Funny59/jubilant-couscous/motherboard.kicad_pcb

## KiCad design motherboard.kicad_pcb (2022-05-28)

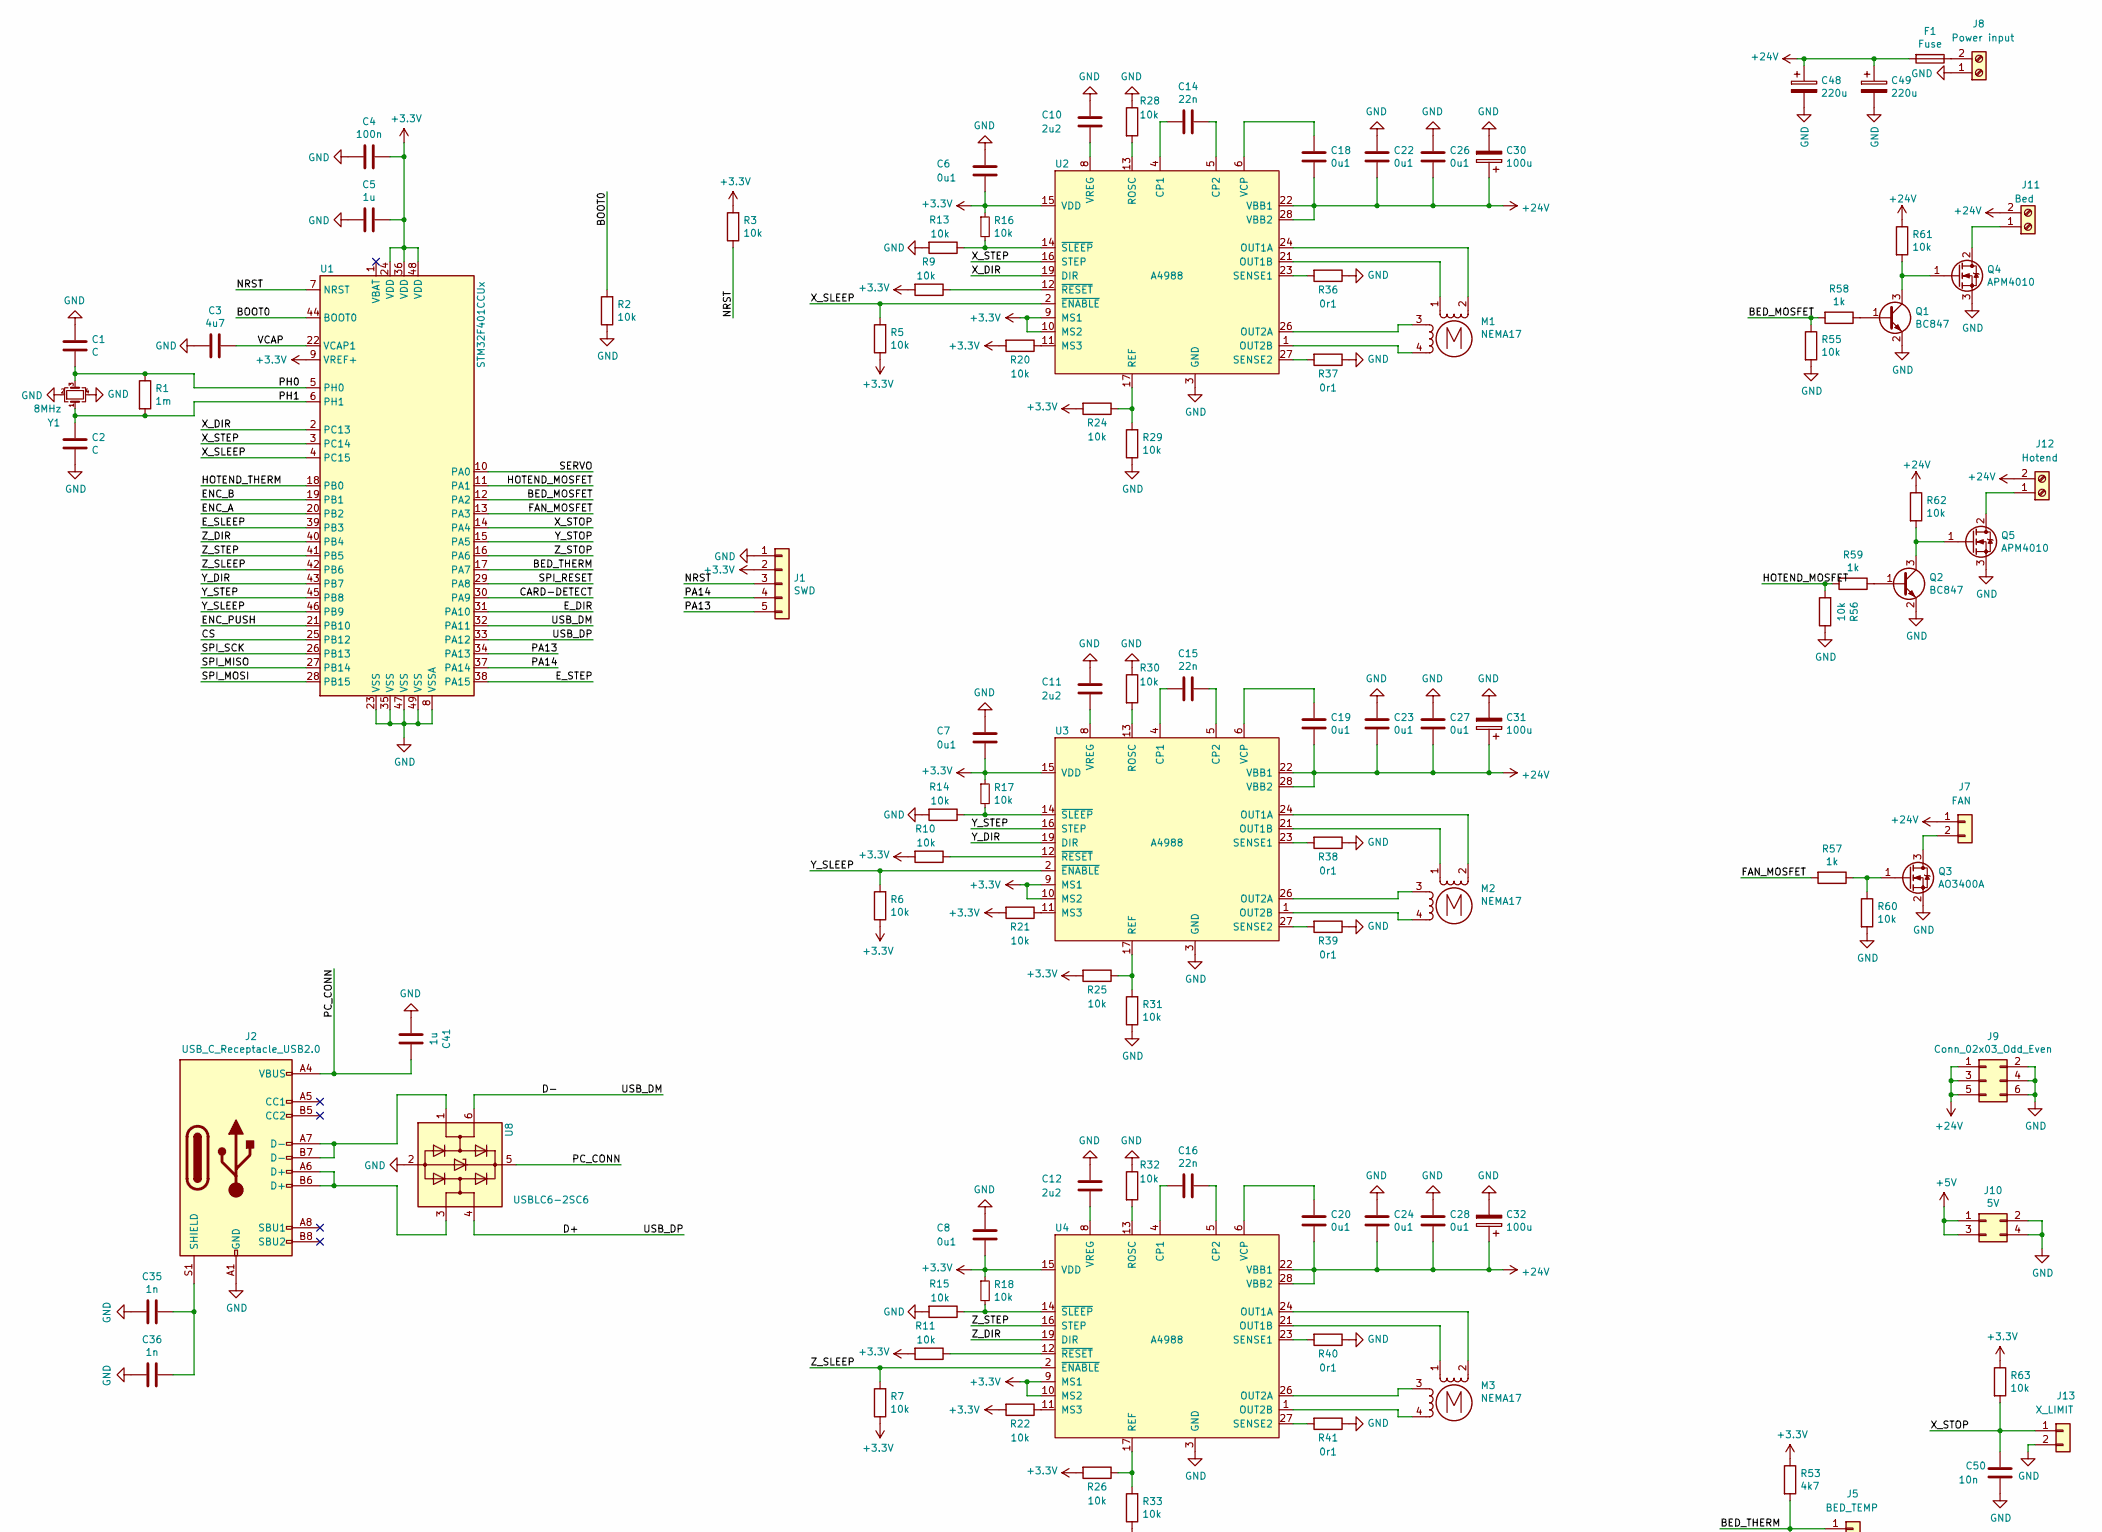
[picture p1: schematic motherboard.sch, part in row 1, column 1]

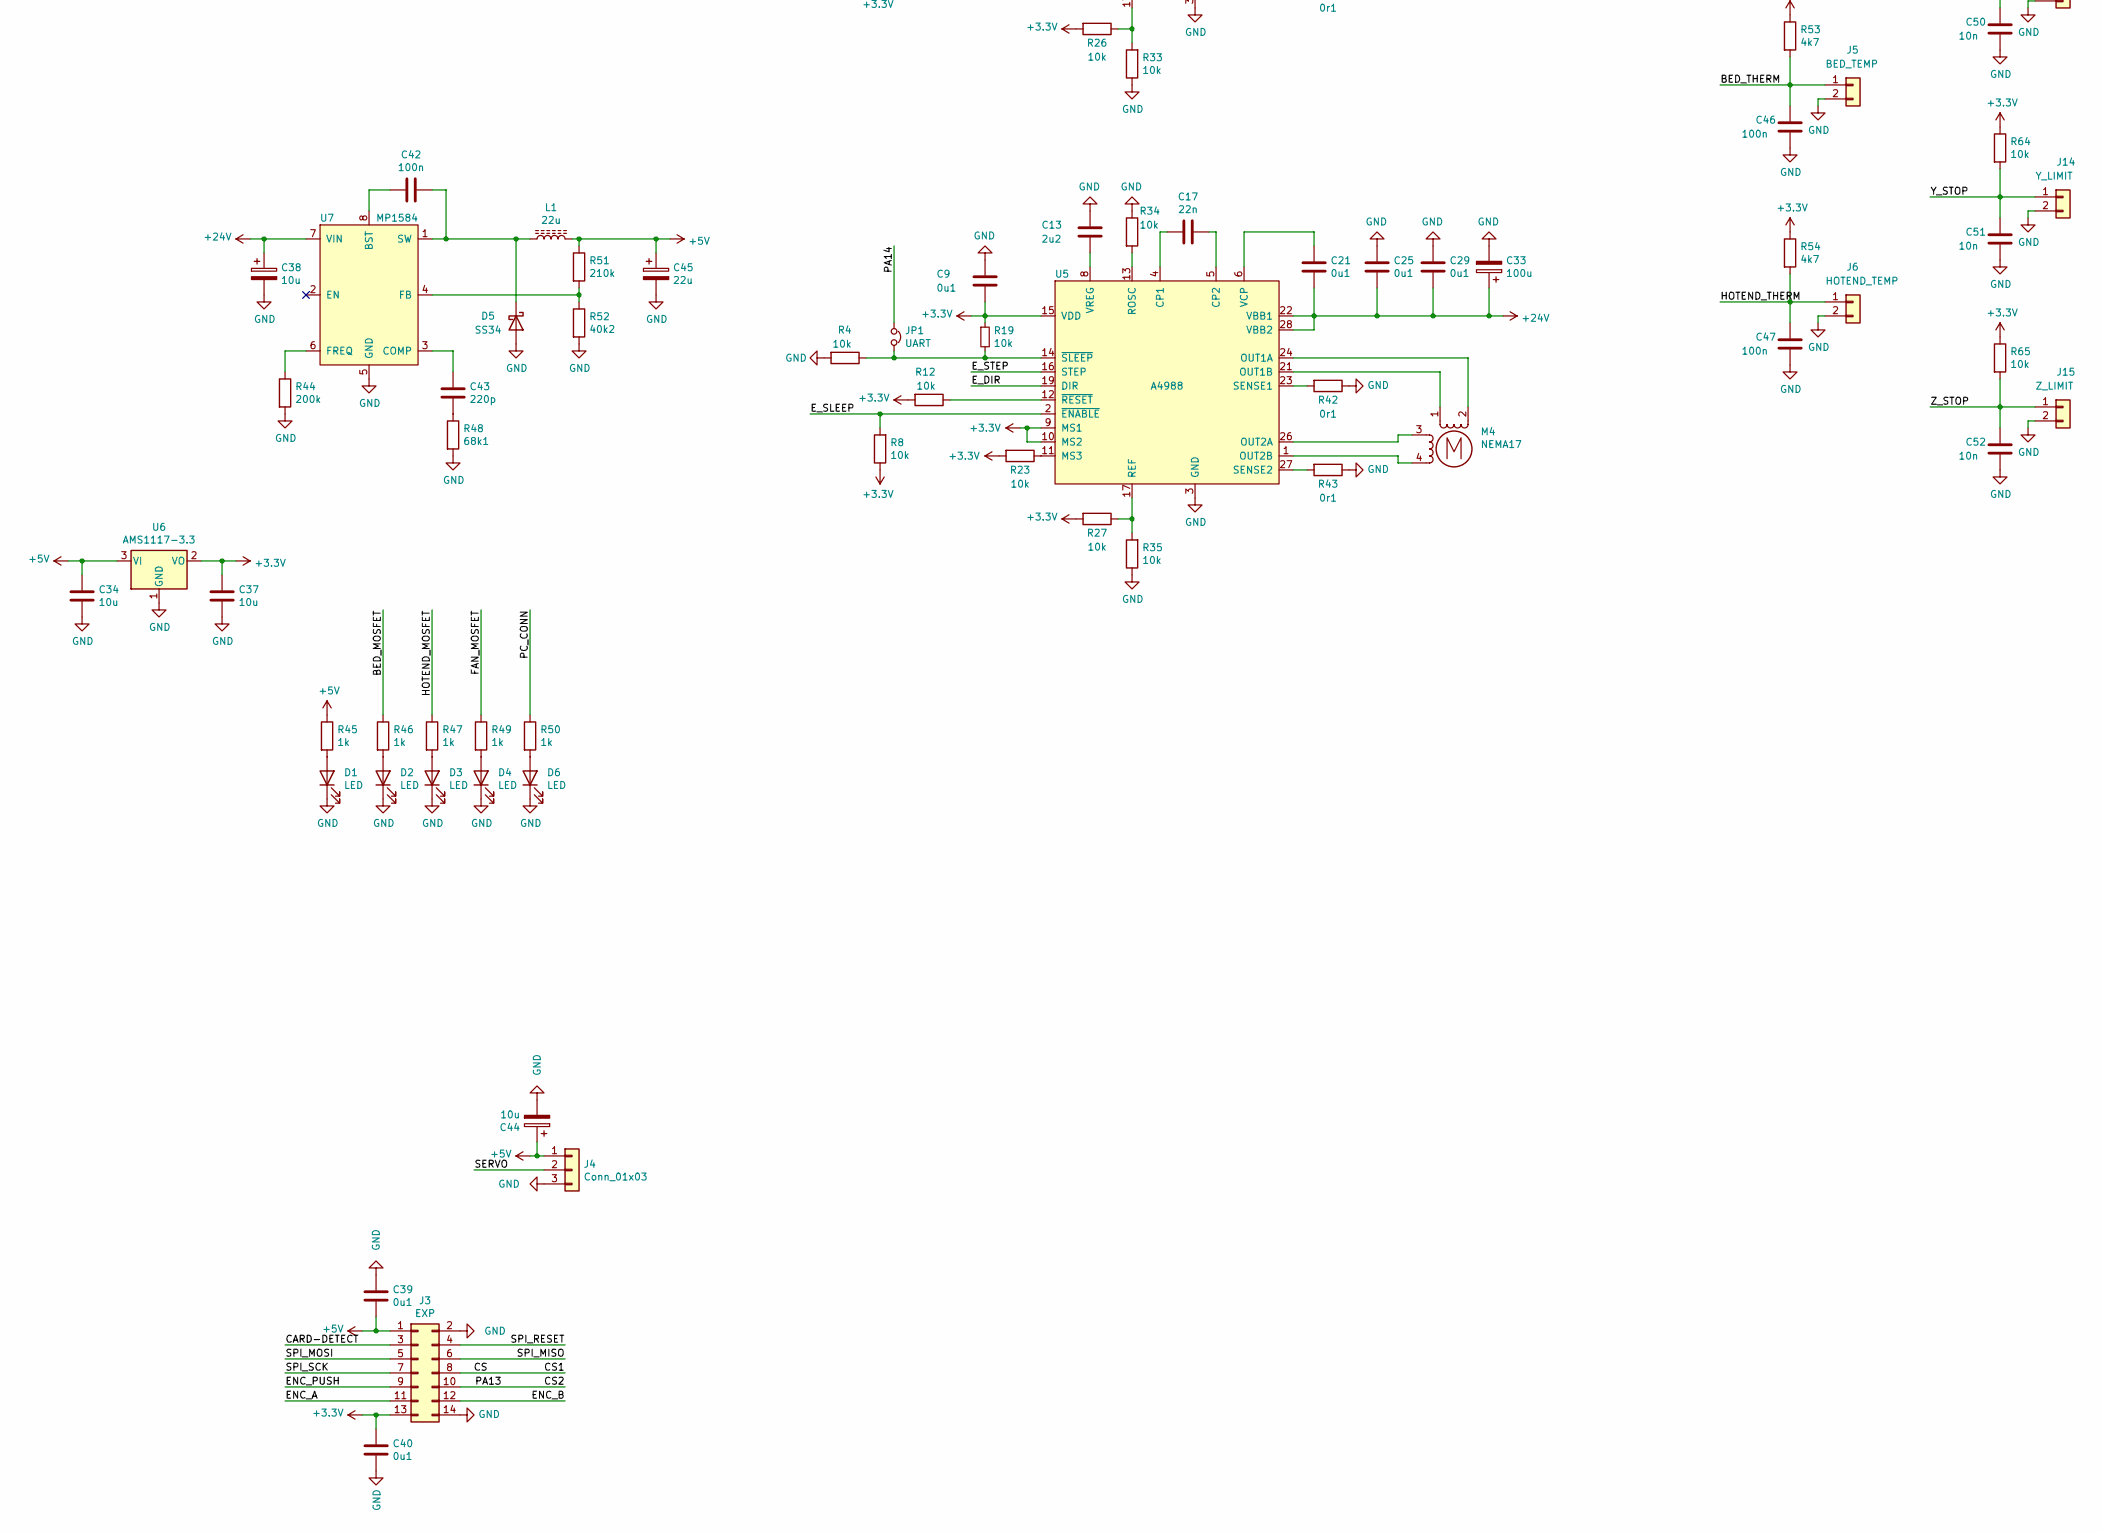
[picture p2: schematic motherboard.sch, part in row 2, column 1]

Parts:
C1, C2: C; C_0603_1608Metric_Pad1.08x0.95mm_HandSolder
C3: 4u7; C_0603_1608Metric_Pad1.08x0.95mm_HandSolder
C4, C42, C46, C47: 100n; C_0603_1608Metric_Pad1.08x0.95mm_HandSolder
C5, C41: 1u; C_0603_1608Metric_Pad1.08x0.95mm_HandSolder
C6, C7, C8, C9, C18, C19, C20, C21, C22, C23, C24, C25, C26, C27, C28, C29, C39, C40: 0u1; C_0603_1608Metric_Pad1.08x0.95mm_HandSolder
C10, C11, C12, C13: 2u2; C_0603_1608Metric_Pad1.08x0.95mm_HandSolder
C14, C15, C16, C17: 22n; C_0603_1608Metric_Pad1.08x0.95mm_HandSolder
C30, C31, C32, C33: 100u; CP_Radial_D8.0mm_P3.50mm
C34, C37: 10u; C_0805_2012Metric_Pad1.18x1.45mm_HandSolder
C35, C36: 1n; C_0603_1608Metric_Pad1.08x0.95mm_HandSolder
C38, C44: 10u; CP_EIA-3528-21_Kemet-B_Pad1.50x2.35mm_HandSolder
C43: 220p; C_0603_1608Metric_Pad1.08x0.95mm_HandSolder
C45: 22u; CP_EIA-3528-21_Kemet-B_Pad1.50x2.35mm_HandSolder
C48, C49: 220u; CP_Radial_D8.0mm_P3.50mm
C50, C51, C52: 10n; C_0603_1608Metric_Pad1.08x0.95mm_HandSolder
D1, D2, D3, D4, D6: LED; LED_0603_1608Metric_Pad1.05x0.95mm_HandSolder
D5: SS34; D_SMA-SMB_Universal_Handsoldering
F1: Fuse; Fuse_Blade_Mini_directSolder
J1: SWD; PinHeader_1x05_P2.54mm_Vertical
J2: USB_C_Receptacle_USB2.0; USB_C_Receptacle_Palconn_UTC16-G
J3: EXP; IDC-Header_2x07_P2.54mm_Vertical
J4: Conn_01x03; JST_XH_B3B-XH-A_1x03_P2.50mm_Vertical
J5: BED_TEMP; JST_XH_B2B-XH-A_1x02_P2.50mm_Vertical
J6: HOTEND_TEMP; JST_XH_B2B-XH-A_1x02_P2.50mm_Vertical
J7: FAN; JST_XH_B2B-XH-A_1x02_P2.50mm_Vertical
J8: Power input; TerminalBlock_bornier-2_P5.08mm
J9: Conn_02x03_Odd_Even; PinHeader_2x03_P2.54mm_Vertical
J10: 5V; PinHeader_2x02_P2.54mm_Vertical
J11: Bed; TerminalBlock_bornier-2_P5.08mm
J12: Hotend; TerminalBlock_bornier-2_P5.08mm
J13: X_LIMIT; JST_XH_B2B-XH-A_1x02_P2.50mm_Vertical
J14: Y_LIMIT; JST_XH_B2B-XH-A_1x02_P2.50mm_Vertical
J15: Z_LIMIT; JST_XH_B2B-XH-A_1x02_P2.50mm_Vertical
JP1: UART; SolderJumper-2_P1.3mm_Open_TrianglePad1.0x1.5mm
L1: 22u; SDR0604
M1, M2, M3, M4: NEMA17; JST_XH_B4B-XH-A_1x04_P2.50mm_Vertical
Q1, Q2: BC847; SOT-23
Q3: AO3400A; SOT-23
Q4, Q5: APM4010; TO-252-2
R1: 1m; R_0603_1608Metric_Pad0.98x0.95mm_HandSolder
R2, R3, R24, R25, R26, R27, R55, R56, R60, R61, R62, R63, R64, R65: 10k; R_0603_1608Metric_Pad0.98x0.95mm_HandSolder
R4, R5, R6, R7, R8, R9, R10, R11, R12, R13, R14, R15, R16, R17, R18, R19, R20, R21, R22, R23, R28, R30, R32, R34: 10k; R_0402_1005Metric_Pad0.72x0.64mm_HandSolder
R29, R31, R33, R35: 10k; Potentiometer_Bourns_TC33X_Vertical
R36, R37, R38, R39, R40, R41, R42, R43: 0r1; R_1206_3216Metric_Pad1.30x1.75mm_HandSolder
R44: 200k; R_0603_1608Metric_Pad0.98x0.95mm_HandSolder
R45, R46, R47, R49, R50, R57, R58, R59: 1k; R_0603_1608Metric_Pad0.98x0.95mm_HandSolder
R48: 68k1; R_0603_1608Metric_Pad0.98x0.95mm_HandSolder
R51: 210k; R_0603_1608Metric_Pad0.98x0.95mm_HandSolder
R52: 40k2; R_0603_1608Metric_Pad0.98x0.95mm_HandSolder
R53, R54: 4k7; R_0603_1608Metric_Pad0.98x0.95mm_HandSolder
U1: STM32F401CCUx; QFN-48-1EP_7x7mm_P0.5mm_EP5.6x5.6mm
U2, U3, U4, U5: A4988; QFN-28-1EP_5x5mm_P0.5mm_EP3.35x3.35mm_ThermalVias
U6: AMS1117-3.3; SOT-223-3_TabPin2
U7: MP1584; SOIC-8-1EP_3.9x4.9mm_P1.27mm_EP2.29x3mm_ThermalVias
U8: USBLC6-2SC6; SOT-23-6
Y1: 8MHz; Crystal_SMD_3225-4Pin_3.2x2.5mm

Connections:
+3V3: C4.1, C5.1, C6.2, C7.2, C8.2, C9.2, C37.1, C40.2, J1.2, J3.13, R3.2, R5.1, R6.1, R7.1, R8.1, R9.2, R10.2, R11.2, R12.2, R16.1, R17.1, R18.1, R19.1, R20.2, R21.2, R22.2, R23.2, R24.2, R25.2, R26.2, R27.2, R53.1, R54.1, R63.1, R64.1, R65.1, U1.9 (VREF+), U1.24 (VDD), U1.36 (VDD), U1.48 (VDD), U2.9 (MS1), U2.10 (MS2), U2.15 (VDD), U3.9 (MS1), U3.10 (MS2), U3.15 (VDD), U4.9 (MS1), U4.10 (MS2), U4.15 (VDD), U5.9 (MS1), U5.10 (MS2), U5.15 (VDD), U6.2 (VO)
+5V: C34.1, C39.1, C44.1, C45.1, J3.1, J4.1, J10.1, J10.3, L1.2, R45.1, R51.1, U6.3 (VI)
+24V: C18.1, C19.1, C20.1, C21.1, C22.1, C23.1, C24.1, C25.1, C26.1, C27.1, C28.1, C29.1, C30.1, C31.1, C32.1, C33.1, C38.1, C48.1, C49.1, F1.2, J7.1, J9.1, J9.3, J9.5, J11.2, J12.2, R61.1, R62.1, U2.22 (VBB1), U2.28 (VBB2), U3.22 (VBB1), U3.28 (VBB2), U4.22 (VBB1), U4.28 (VBB2), U5.22 (VBB1), U5.28 (VBB2), U7.7 (VIN); also elsewhere on the board
/BED_MOSFET: R46.1, R55.1, R58.2, U1.12 (PA2)
/BED_THERM: C46.1, J5.1, R53.2, U1.17 (PA7)
/BOOT0: R2.2, U1.44 (BOOT0)
/CARD-DETECT: J3.3, U1.30 (PA9)
/CS: J3.8, U1.25 (PB12)
/CS2: J1.5, J3.10, U1.34 (PA13)
/D+: U1.33 (PA12), U8.4 (I/O2)
/D-: U1.32 (PA11), U8.6 (I/O1)
/ENC_A: J3.11, U1.20 (PB2)
/ENC_B: J3.12, U1.19 (PB1)
/ENC_PUSH: J3.9, U1.21 (PB10)
/E_DIR: U1.31 (PA10), U5.19 (DIR)
/E_SLEEP: R8.2, U1.39 (PB3), U5.2 (~ENABLE)
/E_STEP: U1.38 (PA15), U5.16 (STEP)
/FAN_MOSFET: R49.1, R57.2, U1.13 (PA3)
/HOTEND_MOSFET: R47.1, R56.2, R59.2, U1.11 (PA1)
/HOTEND_THERM: C47.1, J6.1, R54.2, U1.18 (PB0)
/NRST: J1.3, R3.1, U1.7 (NRST)
/PA14: J1.4, JP1.1, U1.37 (PA14)
/PC_CONN: C41.1, J2.A4 (VBUS), J2.A9 (VBUS), J2.B4 (VBUS), J2.B9 (VBUS), R50.1, U8.5 (VBUS)
/PH0: C1.2, R1.1, U1.5 (PH0), Y1.3
/PH1: C2.1, R1.2, U1.6 (PH1), Y1.1
/SERVO: J4.2, U1.10 (PA0)
/SPI_MISO: J3.6, U1.27 (PB14)
/SPI_MOSI: J3.5, U1.28 (PB15)
/SPI_RESET: J3.4, U1.29 (PA8)
/SPI_SCK: J3.7, U1.26 (PB13)
/VCAP: C3.1, U1.22 (VCAP1)
/X_DIR: U1.2 (PC13), U2.19 (DIR)
/X_SLEEP: R5.2, U1.4 (PC15), U2.2 (~ENABLE)
/X_STEP: U1.3 (PC14), U2.16 (STEP)
/X_STOP: C50.1, J13.1, R63.2, U1.14 (PA4)
/Y_DIR: U1.43 (PB7), U3.19 (DIR)
/Y_SLEEP: R6.2, U1.46 (PB9), U3.2 (~ENABLE)
/Y_STEP: U1.45 (PB8), U3.16 (STEP)
/Y_STOP: C51.1, J14.1, R64.2, U1.15 (PA5)
/Z_DIR: U1.40 (PB4), U4.19 (DIR)
/Z_SLEEP: R7.2, U1.42 (PB6), U4.2 (~ENABLE)
/Z_STEP: U1.41 (PB5), U4.16 (STEP)
/Z_STOP: C52.1, J15.1, R65.2, U1.16 (PA6)
GND: C1.1, C2.2, C3.2, C4.2, C5.2, C6.1, C7.1, C8.1, C9.1, C10.1, C11.1, C12.1, C13.1, C22.2, C23.2, C24.2, C25.2, C26.2, C27.2, C28.2, C29.2, C30.2, C31.2, C32.2, C33.2, C34.2, C35.2, C36.2, C37.2, C38.2, C39.2, C40.1, C41.2, C44.2, C45.2, C46.2, C47.2, C48.2, C49.2, C50.2, C51.2, C52.2, D1.1 (K), D2.1 (K), D3.1 (K), D4.1 (K), D5.2 (A), D6.1 (K), J1.1, J2.A1 (GND), J2.A12 (GND), J2.B1 (GND), J2.B12 (GND), J3.2, J3.14, J4.3, J5.2, J6.2, J8.1, J9.2, J9.4, J9.6, J10.2, J10.4, J13.2, J14.2, J15.2, Q1.2 (E), Q2.2 (E), Q3.2 (S), Q4.3 (S), Q5.3 (S), R2.1, R4.2, R13.2, R14.2, R15.2, R28.1, R29.1, R30.1, R31.1, R32.1, R33.1, R34.1, R35.1, R36.1, R37.1, R38.1, R39.1, R40.1, R41.1, R42.1, R43.1, R44.2, R48.2, R52.2, R55.2, R56.1, R60.2, U1.8 (VSSA), U1.23 (VSS), U1.35 (VSS), U1.47 (VSS), U1.49 (VSS), U2.3 (GND), U2.18 (GND), U2.29 (GND), U3.3 (GND), U3.18 (GND), U3.29 (GND), U4.3 (GND), U4.18 (GND), U4.29 (GND), U5.3 (GND), U5.18 (GND), U5.29 (GND), U6.1 (GND), U7.5 (GND), U8.2 (GND), Y1.2, Y1.4; also elsewhere on the board
unnamed: C10.2, U2.8 (VREG)
unnamed: C11.2, U3.8 (VREG)
unnamed: C12.2, U4.8 (VREG)
unnamed: C13.2, U5.8 (VREG)
unnamed: C14.1, U2.5 (CP2)
unnamed: C14.2, U2.4 (CP1)
unnamed: C15.1, U3.5 (CP2)
unnamed: C15.2, U3.4 (CP1)
unnamed: C16.1, U4.5 (CP2)
unnamed: C16.2, U4.4 (CP1)
unnamed: C17.1, U5.5 (CP2)
unnamed: C17.2, U5.4 (CP1)
unnamed: C18.2, U2.6 (VCP)
unnamed: C19.2, U3.6 (VCP)
unnamed: C20.2, U4.6 (VCP)
unnamed: C21.2, U5.6 (VCP)
unnamed: C35.1, C36.1, J2.S1 (SHIELD)
unnamed: C42.1, D5.1 (K), L1.1, U7.1 (SW)
unnamed: C42.2, U7.8 (BST)
unnamed: C43.1, R48.1
unnamed: C43.2, U7.3 (COMP)
unnamed: D1.2 (A), R45.2
unnamed: D2.2 (A), R46.2
unnamed: D3.2 (A), R47.2
unnamed: D4.2 (A), R49.2
unnamed: D6.2 (A), R50.2
unnamed: F1.1, J8.2
unnamed: J2.A6 (D+), J2.B6 (D+), U8.3 (I/O2)
unnamed: J2.A7 (D-), J2.B7 (D-), U8.1 (I/O1)
unnamed: J7.2, Q3.3 (D)
unnamed: J11.1, Q4.2 (D)
unnamed: J12.1, Q5.2 (D)
unnamed: JP1.2, R4.1, R19.2, U5.14 (~SLEEP)
unnamed: M1.1, U2.21 (OUT1B)
unnamed: M1.2 (-), U2.24 (OUT1A)
unnamed: M1.3, U2.26 (OUT2A)
unnamed: M1.4, U2.1 (OUT2B)
unnamed: M2.1, U3.21 (OUT1B)
unnamed: M2.2 (-), U3.24 (OUT1A)
unnamed: M2.3, U3.26 (OUT2A)
unnamed: M2.4, U3.1 (OUT2B)
unnamed: M3.1, U4.21 (OUT1B)
unnamed: M3.2 (-), U4.24 (OUT1A)
unnamed: M3.3, U4.26 (OUT2A)
unnamed: M3.4, U4.1 (OUT2B)
unnamed: M4.1, U5.21 (OUT1B)
unnamed: M4.2 (-), U5.24 (OUT1A)
unnamed: M4.3, U5.26 (OUT2A)
unnamed: M4.4, U5.1 (OUT2B)
unnamed: Q1.1 (B), R58.1
unnamed: Q1.3 (C), Q4.1 (G), R61.2
unnamed: Q2.1 (B), R59.1
unnamed: Q2.3 (C), Q5.1 (G), R62.2
unnamed: Q3.1 (G), R57.1, R60.1
unnamed: R9.1, U2.12 (~RESET)
unnamed: R10.1, U3.12 (~RESET)
unnamed: R11.1, U4.12 (~RESET)
unnamed: R12.1, U5.12 (~RESET)
unnamed: R13.1, R16.2, U2.14 (~SLEEP)
unnamed: R14.1, R17.2, U3.14 (~SLEEP)
unnamed: R15.1, R18.2, U4.14 (~SLEEP)
unnamed: R20.1, U2.11 (MS3)
unnamed: R21.1, U3.11 (MS3)
unnamed: R22.1, U4.11 (MS3)
unnamed: R23.1, U5.11 (MS3)
unnamed: R24.1, R29.2, U2.17 (REF)
unnamed: R25.1, R31.2, U3.17 (REF)
unnamed: R26.1, R33.2, U4.17 (REF)
unnamed: R27.1, R35.2, U5.17 (REF)
unnamed: R28.2, U2.13 (ROSC)
unnamed: R30.2, U3.13 (ROSC)
unnamed: R32.2, U4.13 (ROSC)
unnamed: R34.2, U5.13 (ROSC)
unnamed: R36.2, U2.23 (SENSE1)
unnamed: R37.2, U2.27 (SENSE2)
unnamed: R38.2, U3.23 (SENSE1)
unnamed: R39.2, U3.27 (SENSE2)
unnamed: R40.2, U4.23 (SENSE1)
unnamed: R41.2, U4.27 (SENSE2)
unnamed: R42.2, U5.23 (SENSE1)
unnamed: R43.2, U5.27 (SENSE2)
unnamed: R44.1, U7.6 (FREQ~)
unnamed: R51.2, R52.1, U7.4 (FB)

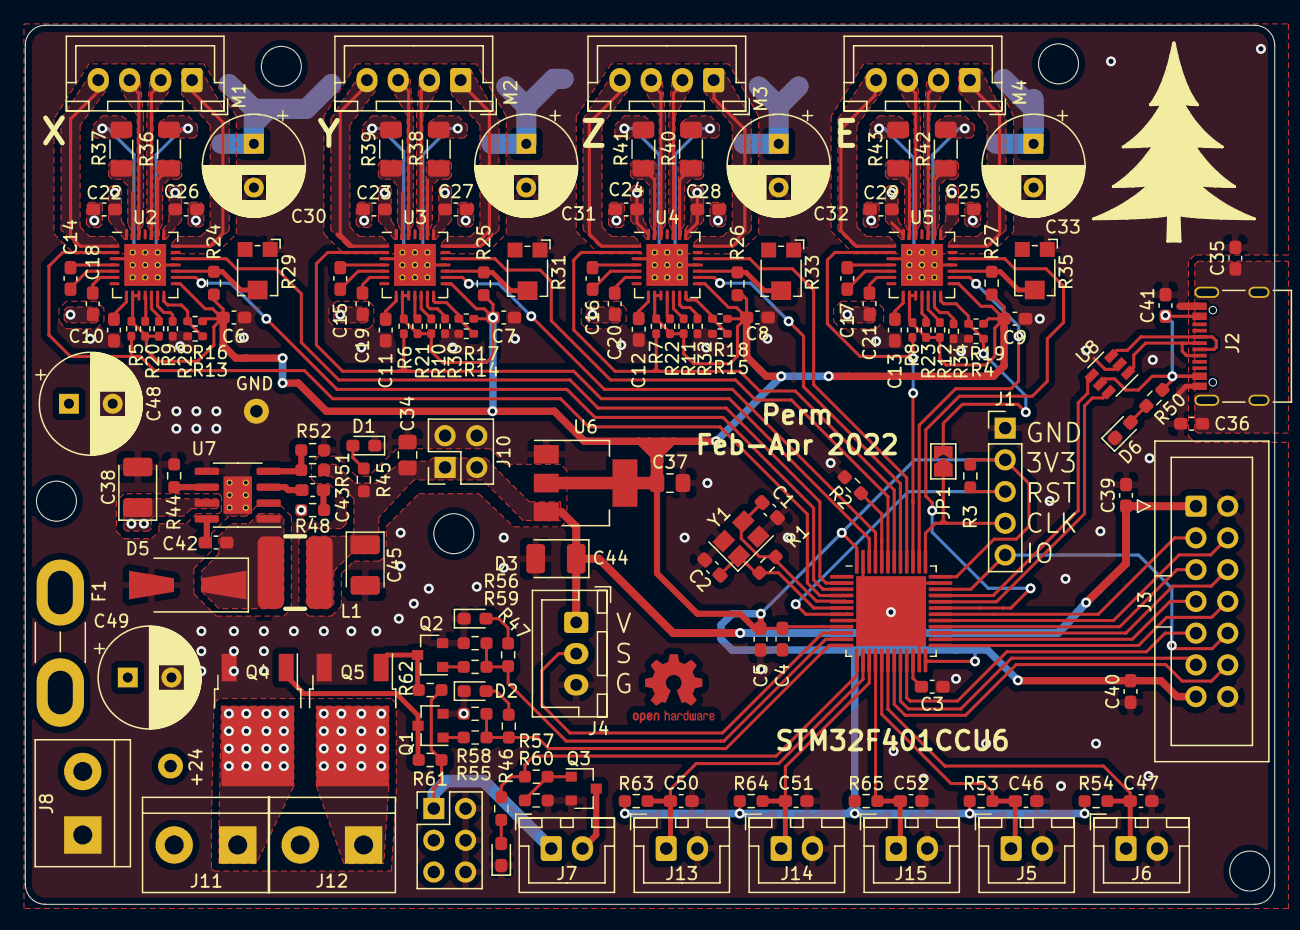
[picture p3: board motherboard.kicad_pcb from above]

Board: 2 copper layers, 100.0 x 70.3 mm, 162 parts (1 on the bottom side), 127 nets.

Other parts of the board:
GND: TestPoint_Loop_D1.80mm_Drill1.0mm_Beaded
GND#2: TestPoint_Loop_D1.80mm_Drill1.0mm_Beaded
QR*****: QR_signed

Their connections:
+24V: GND.1; also elsewhere on the board
GND: GND#2.1; also elsewhere on the board
