Funny59/jubilant-couscous/display_board/motherboard.kicad_pcb

## KiCad design display_board/motherboard.kicad_pcb (2022-05-22)

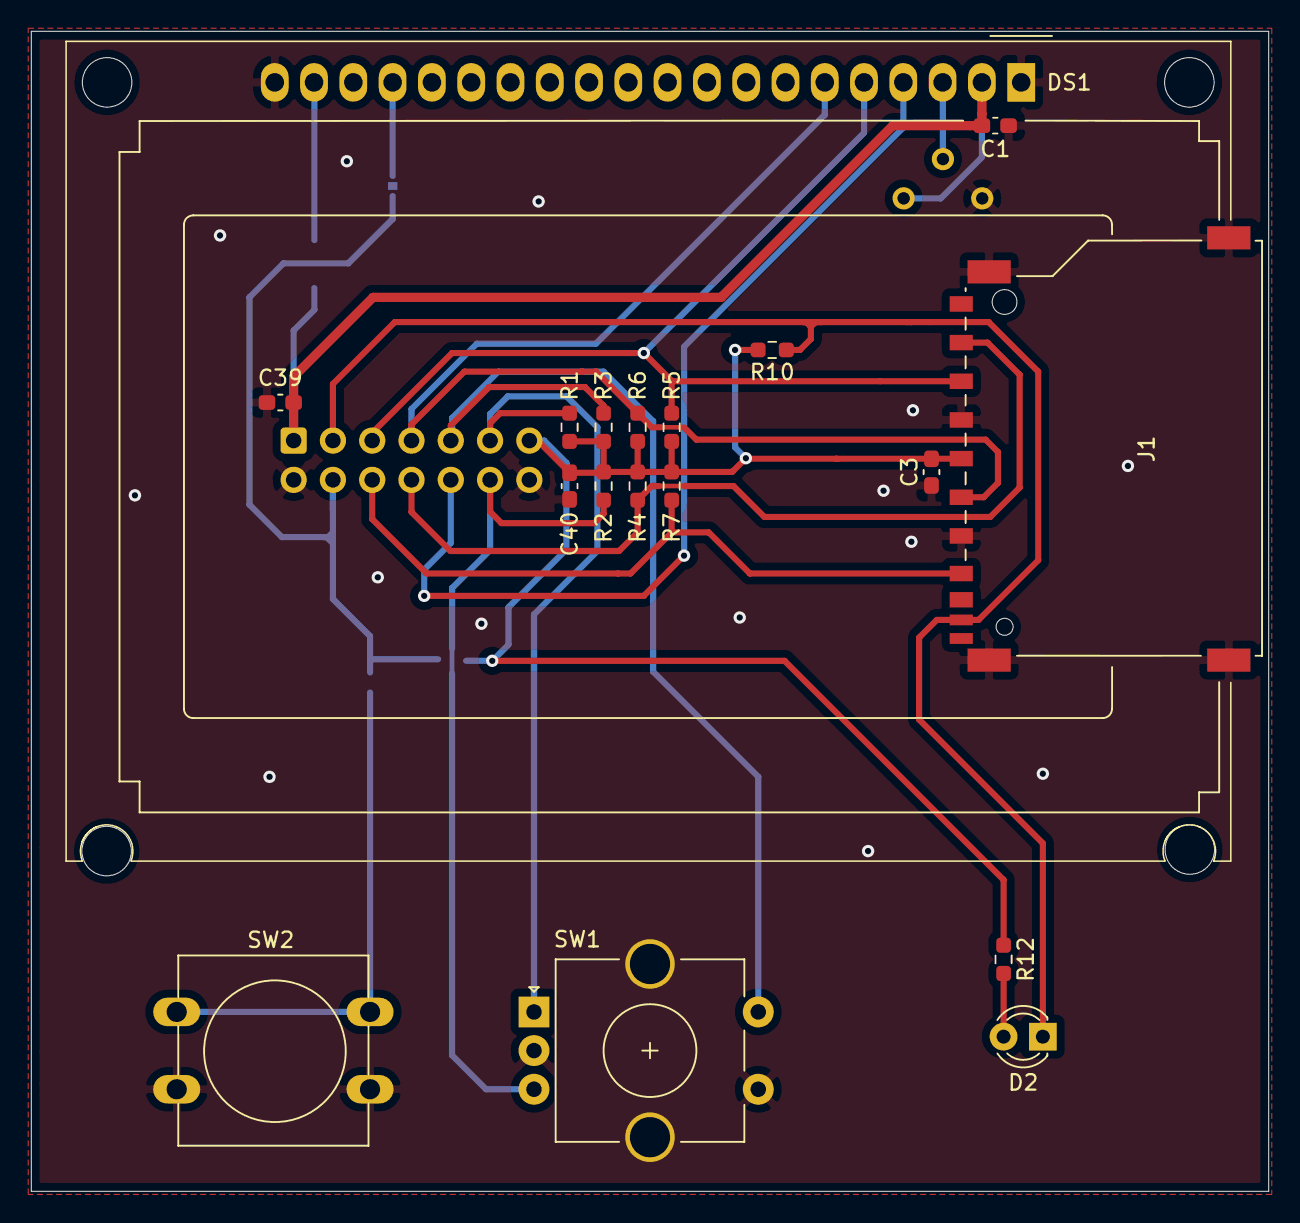
[picture p4: board display_board/motherboard.kicad_pcb from above]

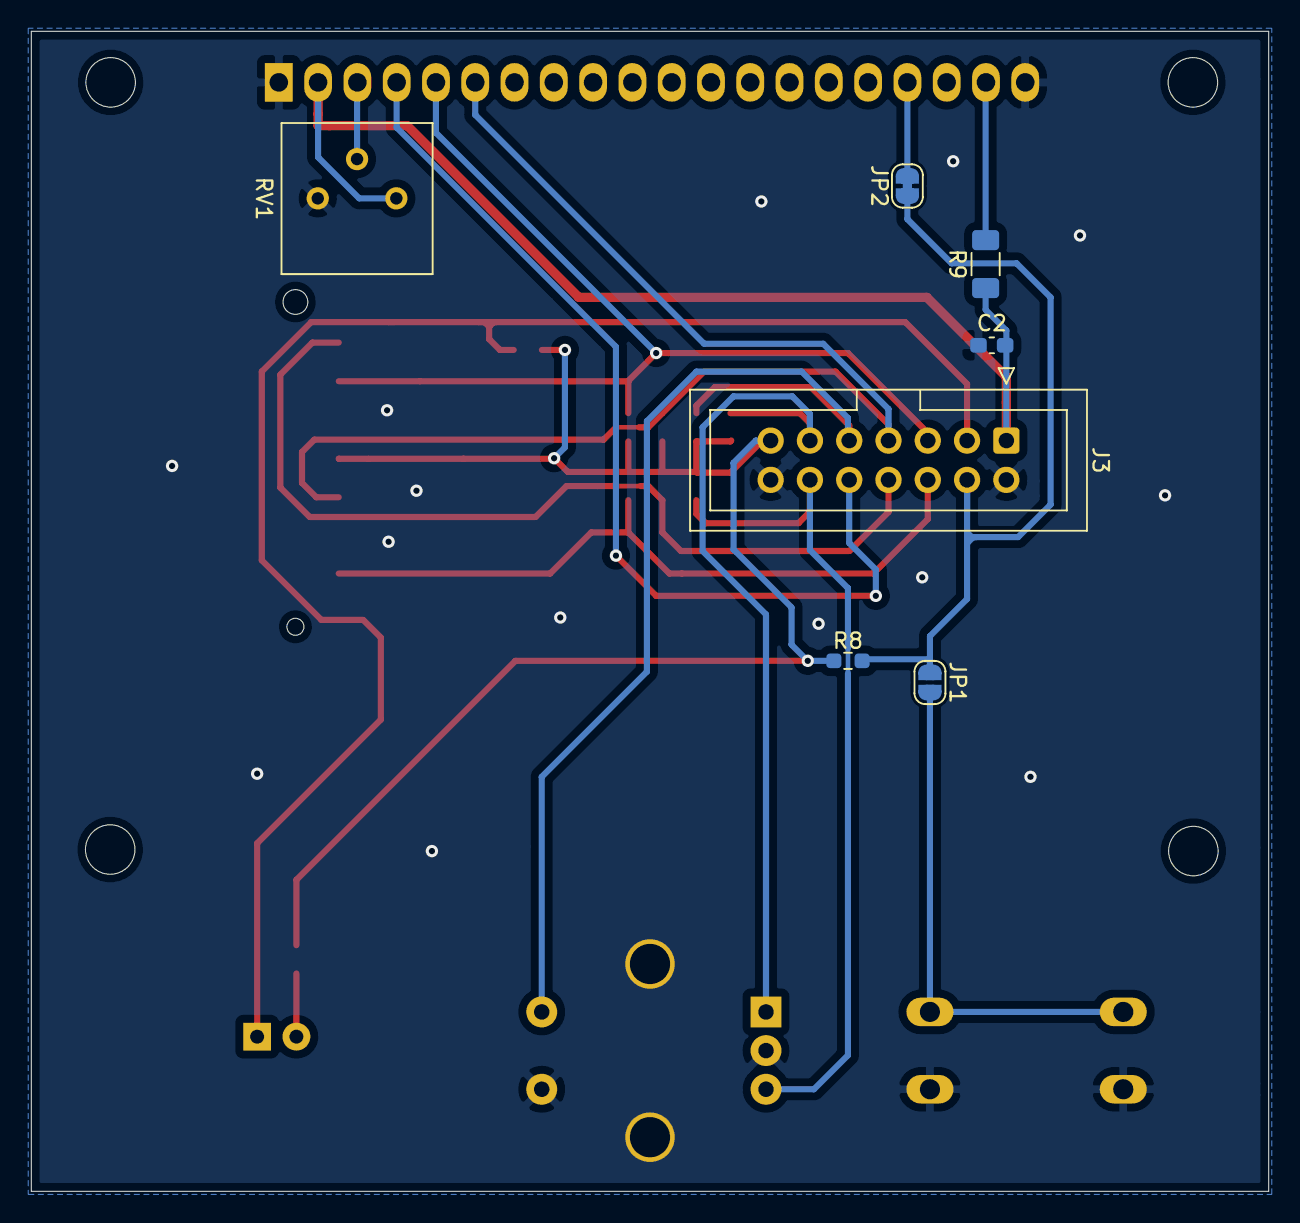
[picture p5: board display_board/motherboard.kicad_pcb from below]

Board: 2 copper layers, 80.0 x 75.0 mm, 25 parts (7 on the bottom side), 18 nets.

Parts:
C1, C2, C3, C39, C40: 0u1; C_0603_1608Metric_Pad1.08x0.95mm_HandSolder
D2: LED; LED_D3.0mm
DS1: LCD12864; AG12864E
J1: SD_Card; SD_TE_2041021
J3: EXP; IDC-Header_2x07_P2.54mm_Vertical
JP1: Jumper_NO_Small; SolderJumper-2_P1.3mm_Open_RoundedPad1.0x1.5mm
JP2: Jumper_NC_Small; SolderJumper-2_P1.3mm_Bridged_RoundedPad1.0x1.5mm
R1, R2, R3, R4, R5, R6, R7, R8, R10: 10k; R_0603_1608Metric_Pad0.98x0.95mm_HandSolder
R9: 470; R_1206_3216Metric_Pad1.30x1.75mm_HandSolder
R12: 470; R_0603_1608Metric_Pad0.98x0.95mm_HandSolder
RV1: 10k; Potentiometer_Bourns_3386P_Vertical
SW1: Rotary_Encoder_Switch; RotaryEncoder_Alps_EC11E-Switch_Vertical_H20mm_CircularMoun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
SW2: SW_Push; SW_PUSH-12mm

Connections:
+3V3: C3.2, C40.2, J1.4, J3.13, R1.2, R2.2, R3.1, R4.2, R5.2, R6.2, R7.2, R8.2, R10.2, R12.1
+5V: C1.1, C2.2, C39.1, DS1.2, J3.1, R9.1, RV1.1
/CARD-DETECT: D2.1, J1.10, J3.3, R10.1
/CS: J1.1, J3.8, R4.1
/CS2: DS1.4, J3.10
/ENC_A: J3.11, R1.1, SW1.A
/ENC_B: J3.12, R2.1, SW1.B
/ENC_PUSH: J3.9, R3.2, SW1.S2
/SPI_MISO: J1.7, J3.6, R7.1
/SPI_MOSI: DS1.5, J1.2, J3.5, R5.1
/SPI_RESET: J3.4, JP1.1, JP2.1, R8.1
/SPI_SCK: DS1.6, J1.5, J3.7, R6.1
GND: C1.2, C2.1, C3.1, C39.2, C40.1, DS1.1, DS1.20, J1.3, J1.6, J1.12, J3.2, J3.14, RV1.3, SW1.C, SW1.S1, SW2.2
unnamed: D2.2, R12.2
unnamed: DS1.3, RV1.2
unnamed: DS1.17, JP2.2
unnamed: DS1.19, R9.2
unnamed: JP1.2, SW2.1
