Funny59/jubilant-couscous/todo.txt

1. Расчистить место под радиаторы драйверов
2. Переделать Драйверы x, y, e под один пин sleep
3. Добавить разъем для датчика филмаента или еще один cs пин (альтернативно)
4. Добавить второй регулируемый вентилятор
