Funny59/jubilant-couscous/(commit log)

2022-02-08 new pcb and fix schematic
    [motherboard.kicad_pcb, motherboard.sch]
2022-02-28 change connection from USB to UART to support STM32 without USB
    [motherboard.kicad_pcb, motherboard.sch]
2022-05-14 change PCB design
    [motherboard.kicad_pcb, motherboard.sch]
2022-05-15 add Marlin build
    [Configuration.h, Configuration_adv.h, esp32.csv]
2022-05-22 add display board
    [motherboard.kicad_pcb, motherboard.sch]
2022-05-28 pcb fixes
    [motherboard.kicad_pcb, motherboard.sch]
2022-05-28 add logo to pcb
    [motherboard.kicad_pcb]
